matithemati/chocpilot/app/chocpilot/assets/chocpilot.png

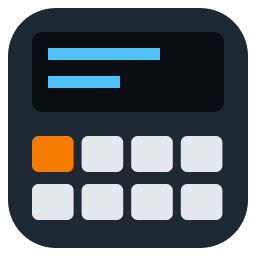
app/chocpilot/assets/chocpilot.png
