matithemati/chocpilot/docs/img/case_exploded.png

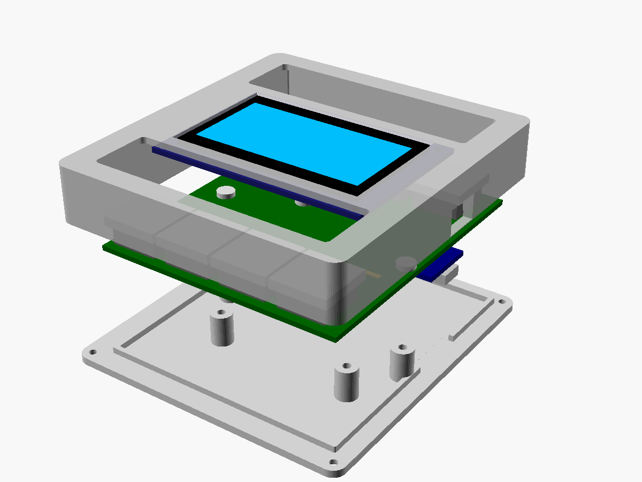
docs/img/case_exploded.png
