matithemati/chocpilot/docs/img/oled_242_shengyang.png

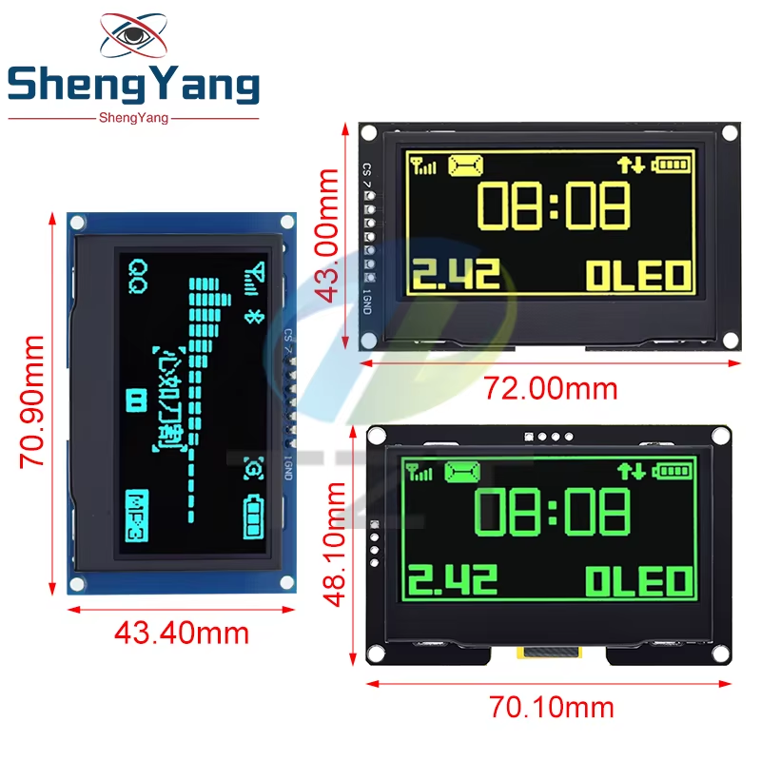
docs/img/oled_242_shengyang.png
