matithemati/chocpilot/docs/img/pcb_compact.png

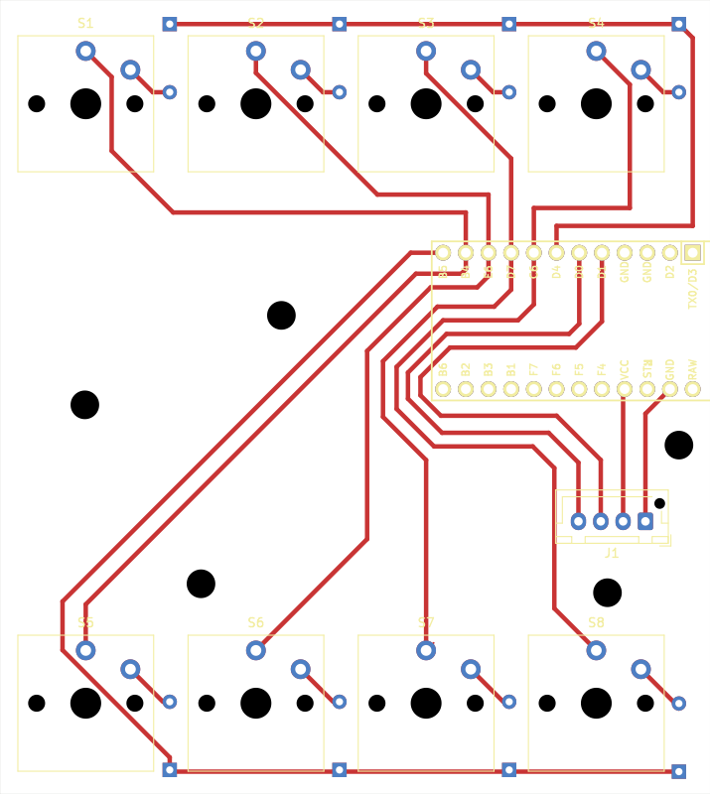
docs/img/pcb_compact.png
