matithemati/chocpilot/docs/schematic.png

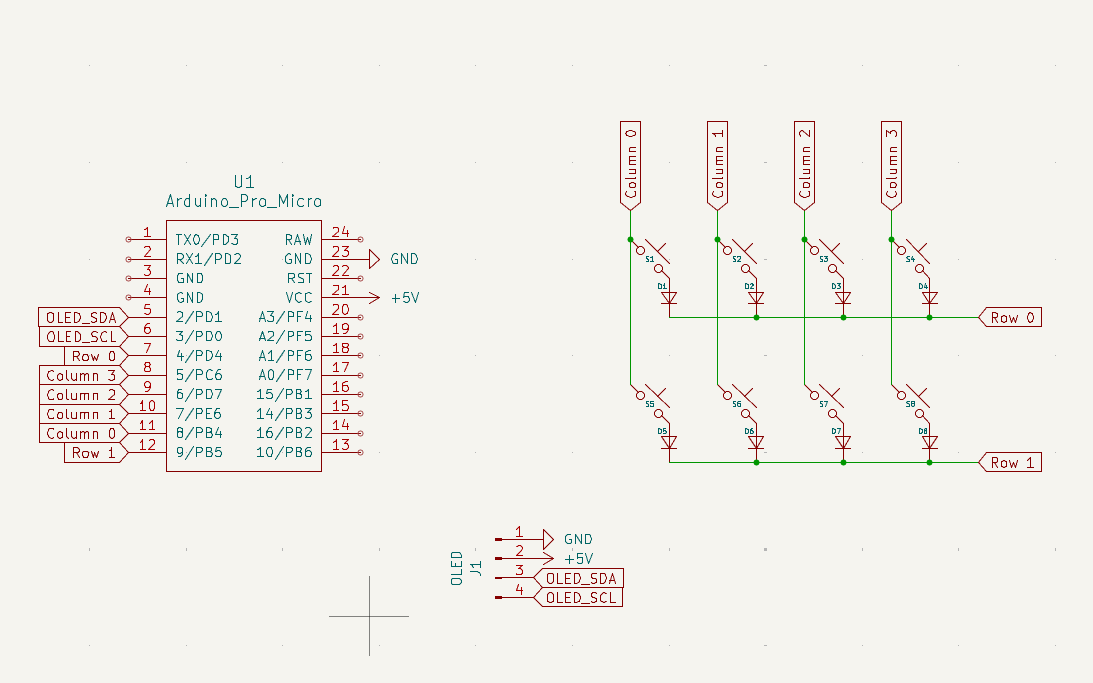
docs/schematic.png
