matithemati/chocpilot/pcb/chocpilot-v2/img/pcb_bottom.png

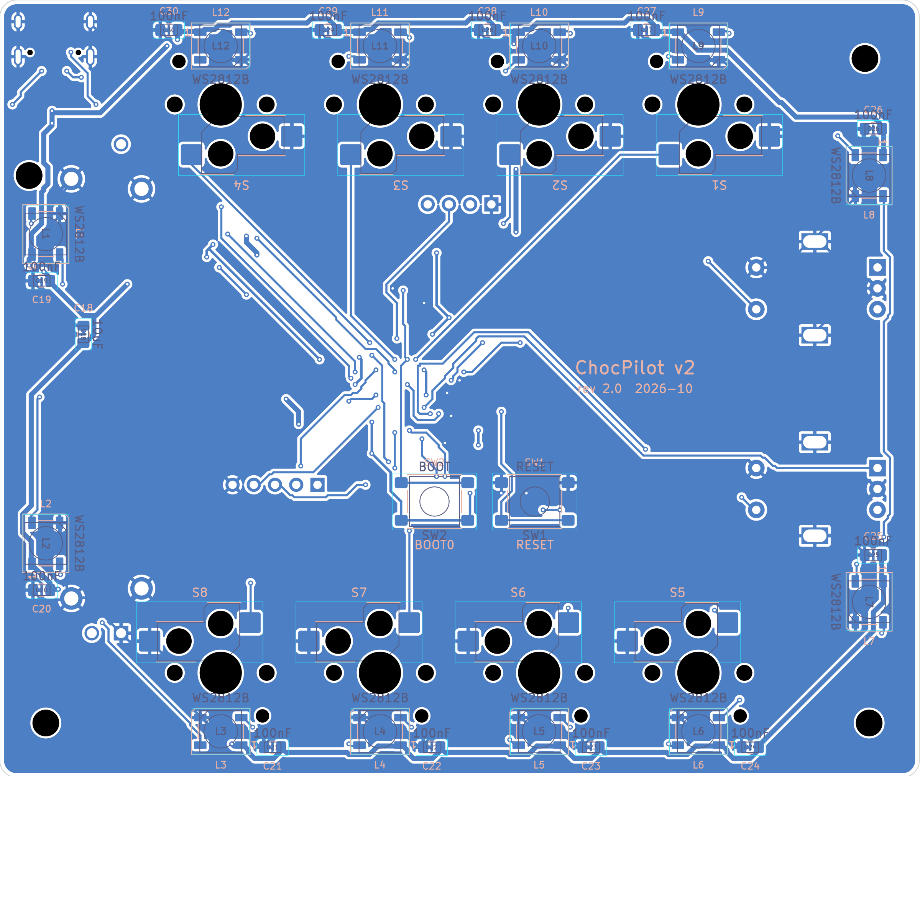
pcb/chocpilot-v2/img/pcb_bottom.png
