matithemati/chocpilot/pcb/chocpilot-v2/img/pcb_top.png

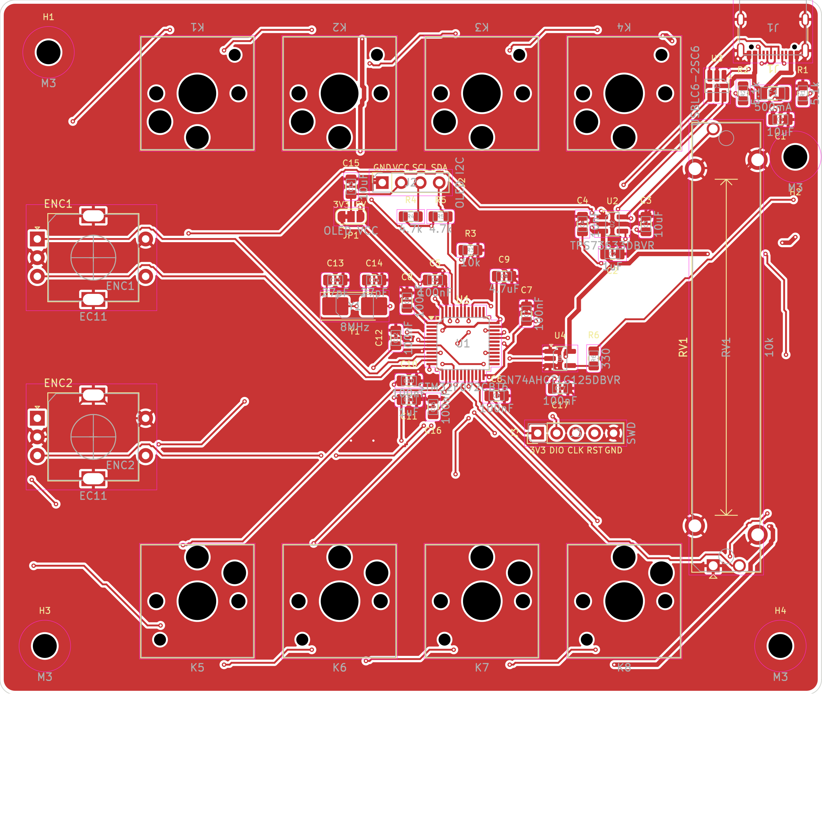
pcb/chocpilot-v2/img/pcb_top.png
