matithemati/chocpilot/pcb/chocpilot-v2/img/render_bottom.png

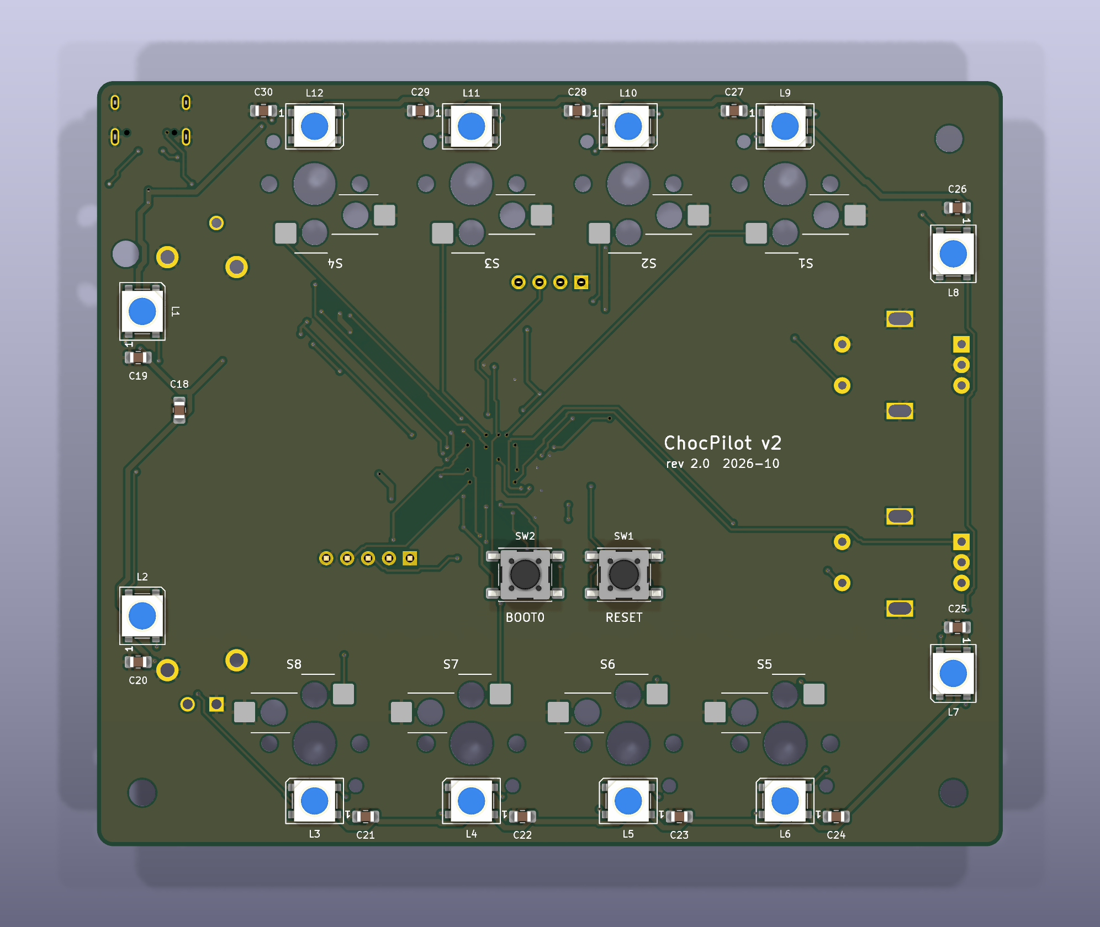
pcb/chocpilot-v2/img/render_bottom.png
