matithemati/chocpilot/pcb/chocpilot-v2/img/schematic.png

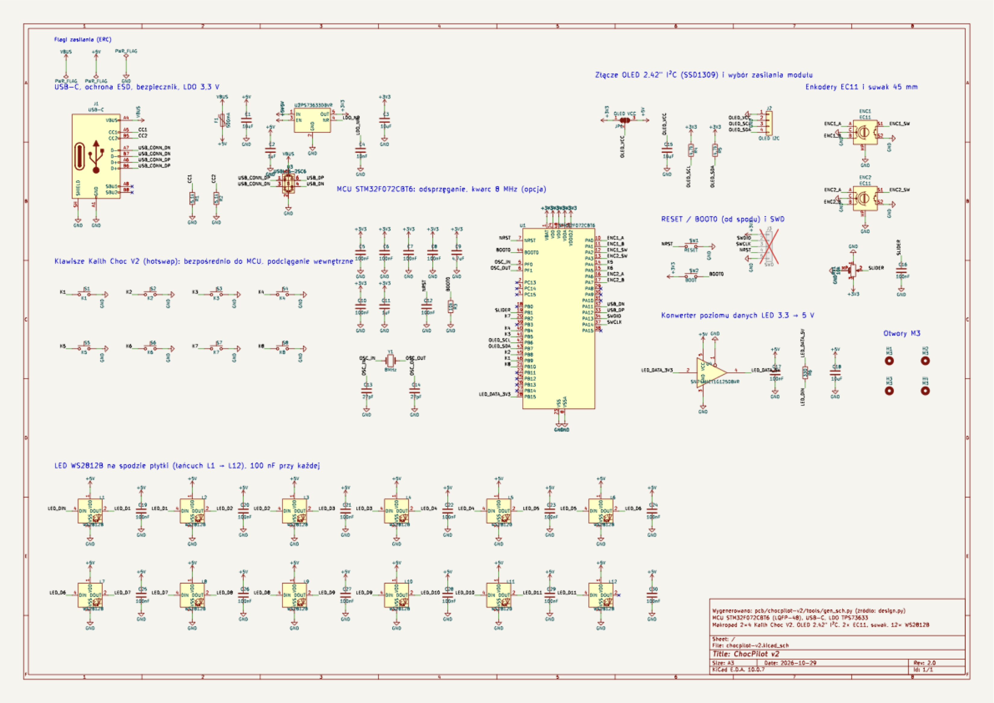
pcb/chocpilot-v2/img/schematic.png
