matithemati/chocpilot/docs/img/case_assembly.png

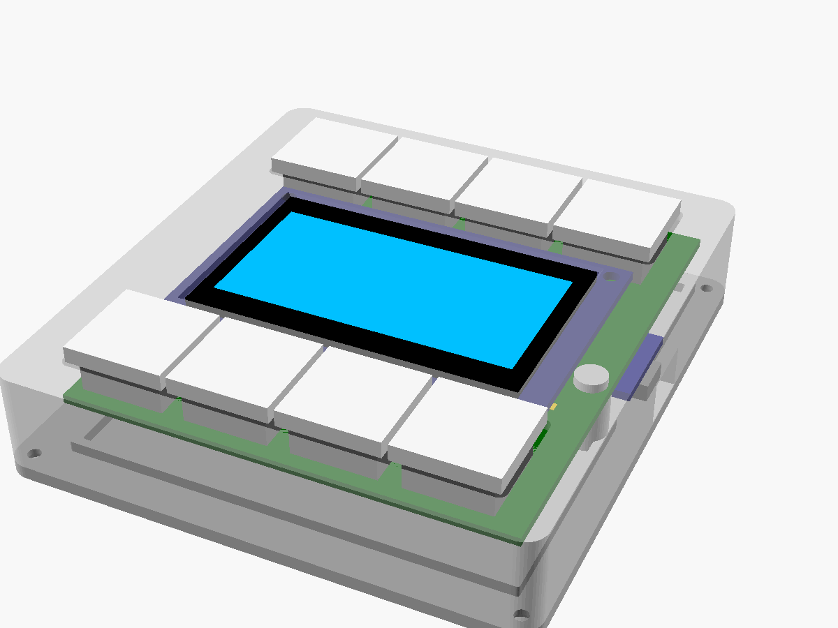
docs/img/case_assembly.png
