matithemati/chocpilot/pcb/chocpilot-v2/img/schematic.pdf

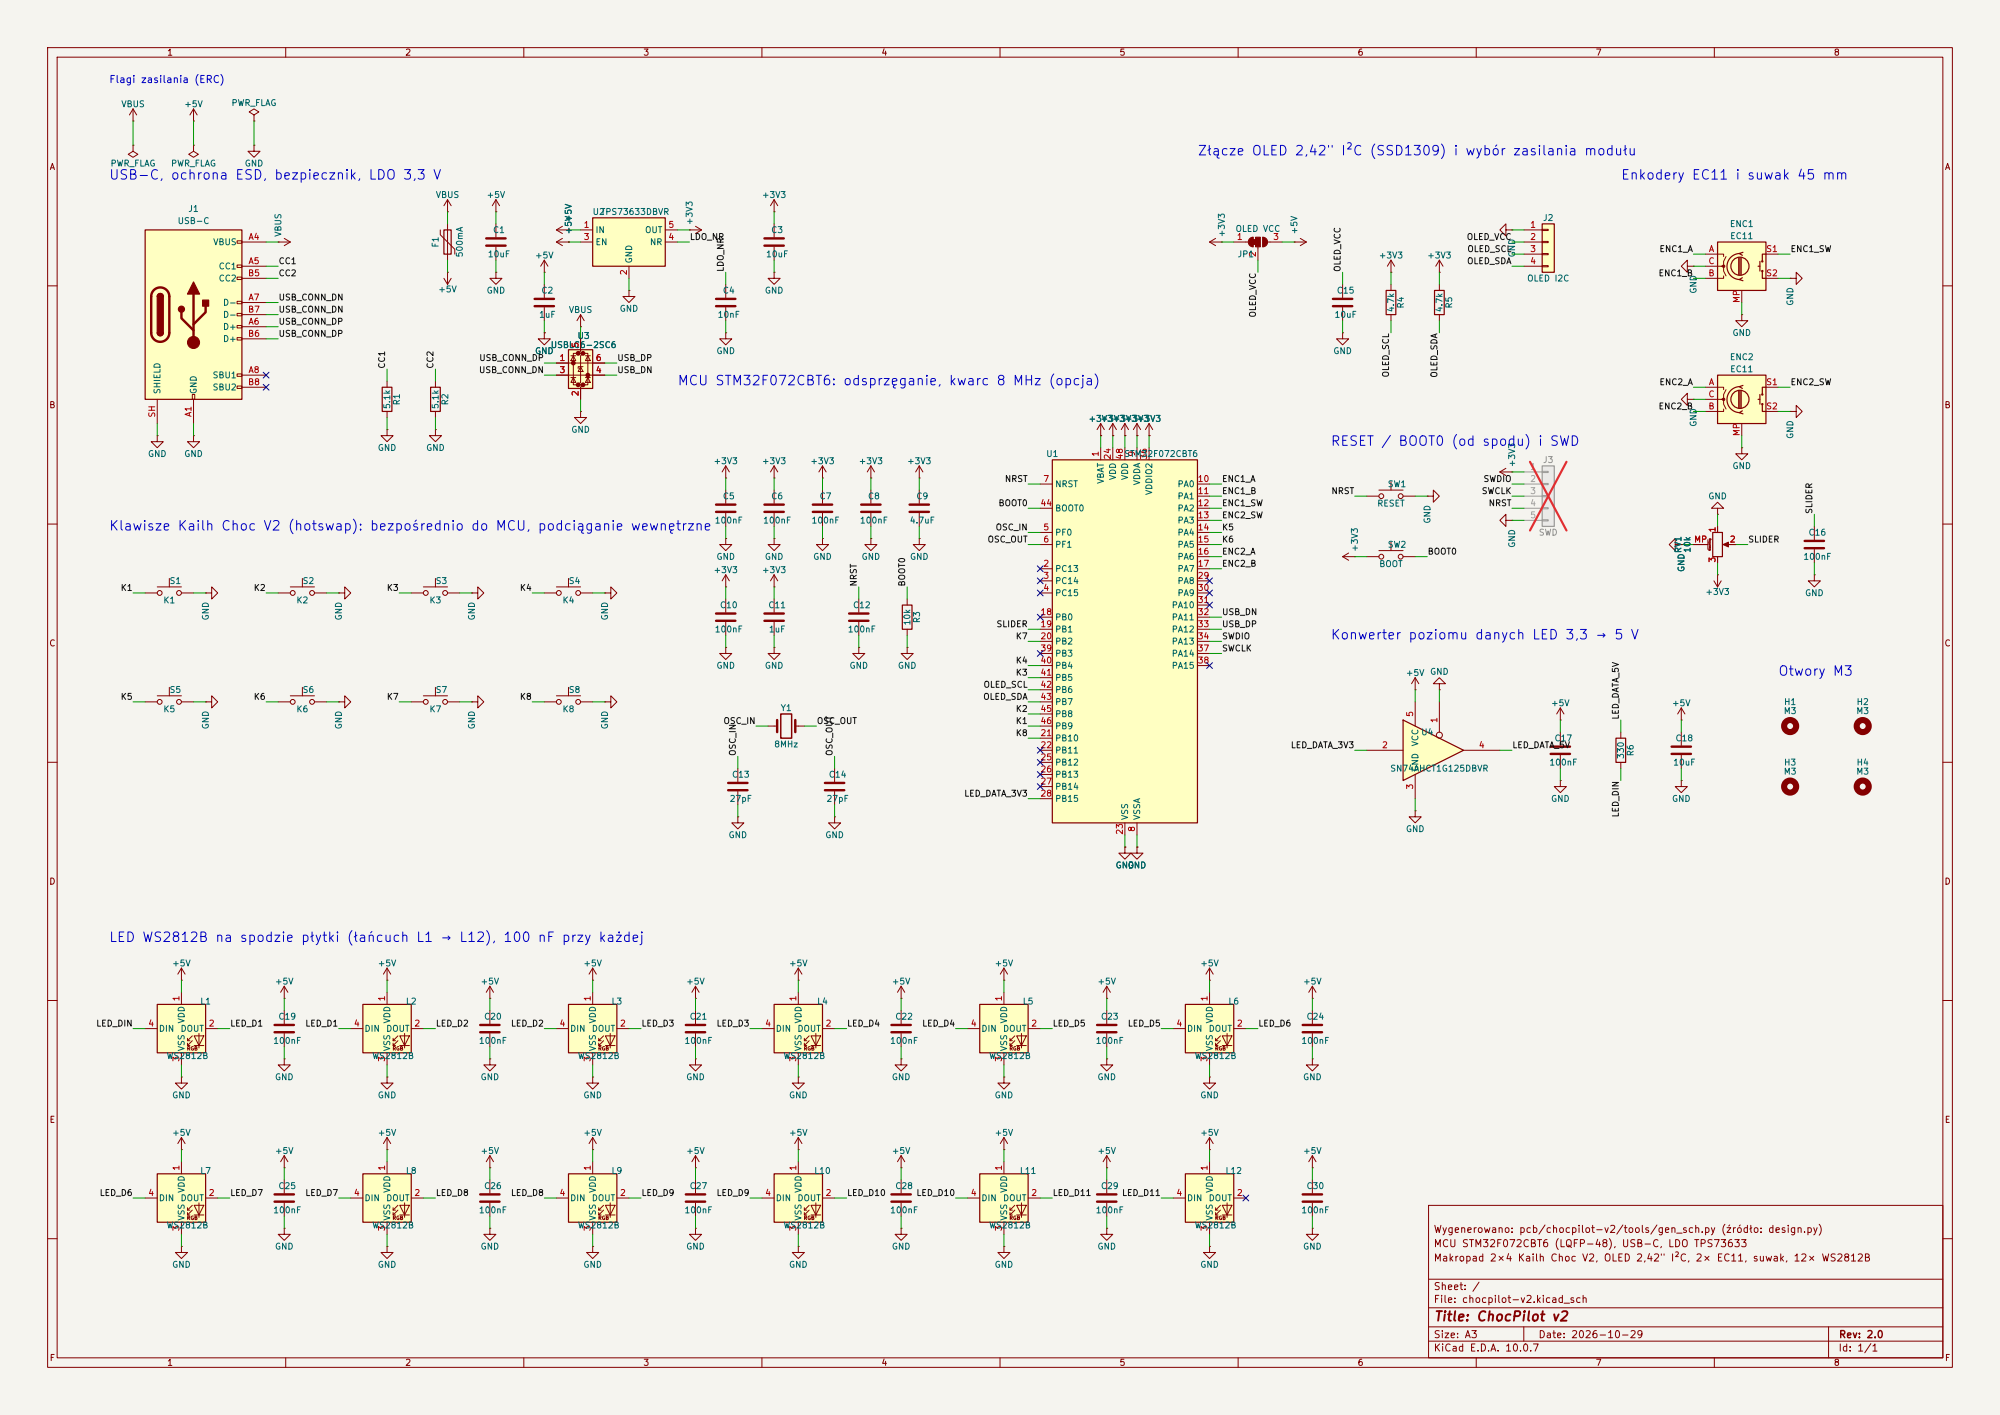
[picture p12: page 1]

Złącze OLED 2,42" I²C (SSD1309) i wybór zasilania modułu
LED_D6 OLED_VCC

USB-C, ochrona ESD, bezpiecznik, LDO 3,3 V

GND
MCU STM32F072CBT6: odsprzęganie, kwarc 8 MHz (opcja)

RESET / BOOT0 (od spodu) i SWD

Klawisze Kailh Choc V2 (hotswap): bezpośrednio do MCU, podciąganie wewnętrzne

Konwerter poziomu danych LED 3,3 → 5 V

LED WS2812B na spodzie płytki (łańcuch L1 → L12), 100 nF przy każdej

Wygenerowano: pcb/chocpilot-v2/tools/gen_sch.py (źródło: design.py) C27
LED_D9

MCU STM32F072CBT6 (LQFP-48), USB-C, LDO TPS73633
Makropad 2×4 Kailh Choc V2, OLED 2,42" I²C, 2× EC11, suwak, 12× WS2812B

Size: A3 | Rev: 2.0 | F Date: 2026-10-29
KiCad E.D.A. 10.0.7 | Id: 1/1
