matithemati/chocpilot/pcb/chocpilot-v2/chocpilot-v2.kicad_pcb

## KiCad design pcb/chocpilot-v2/chocpilot-v2.kicad_pcb (2026-10-29)

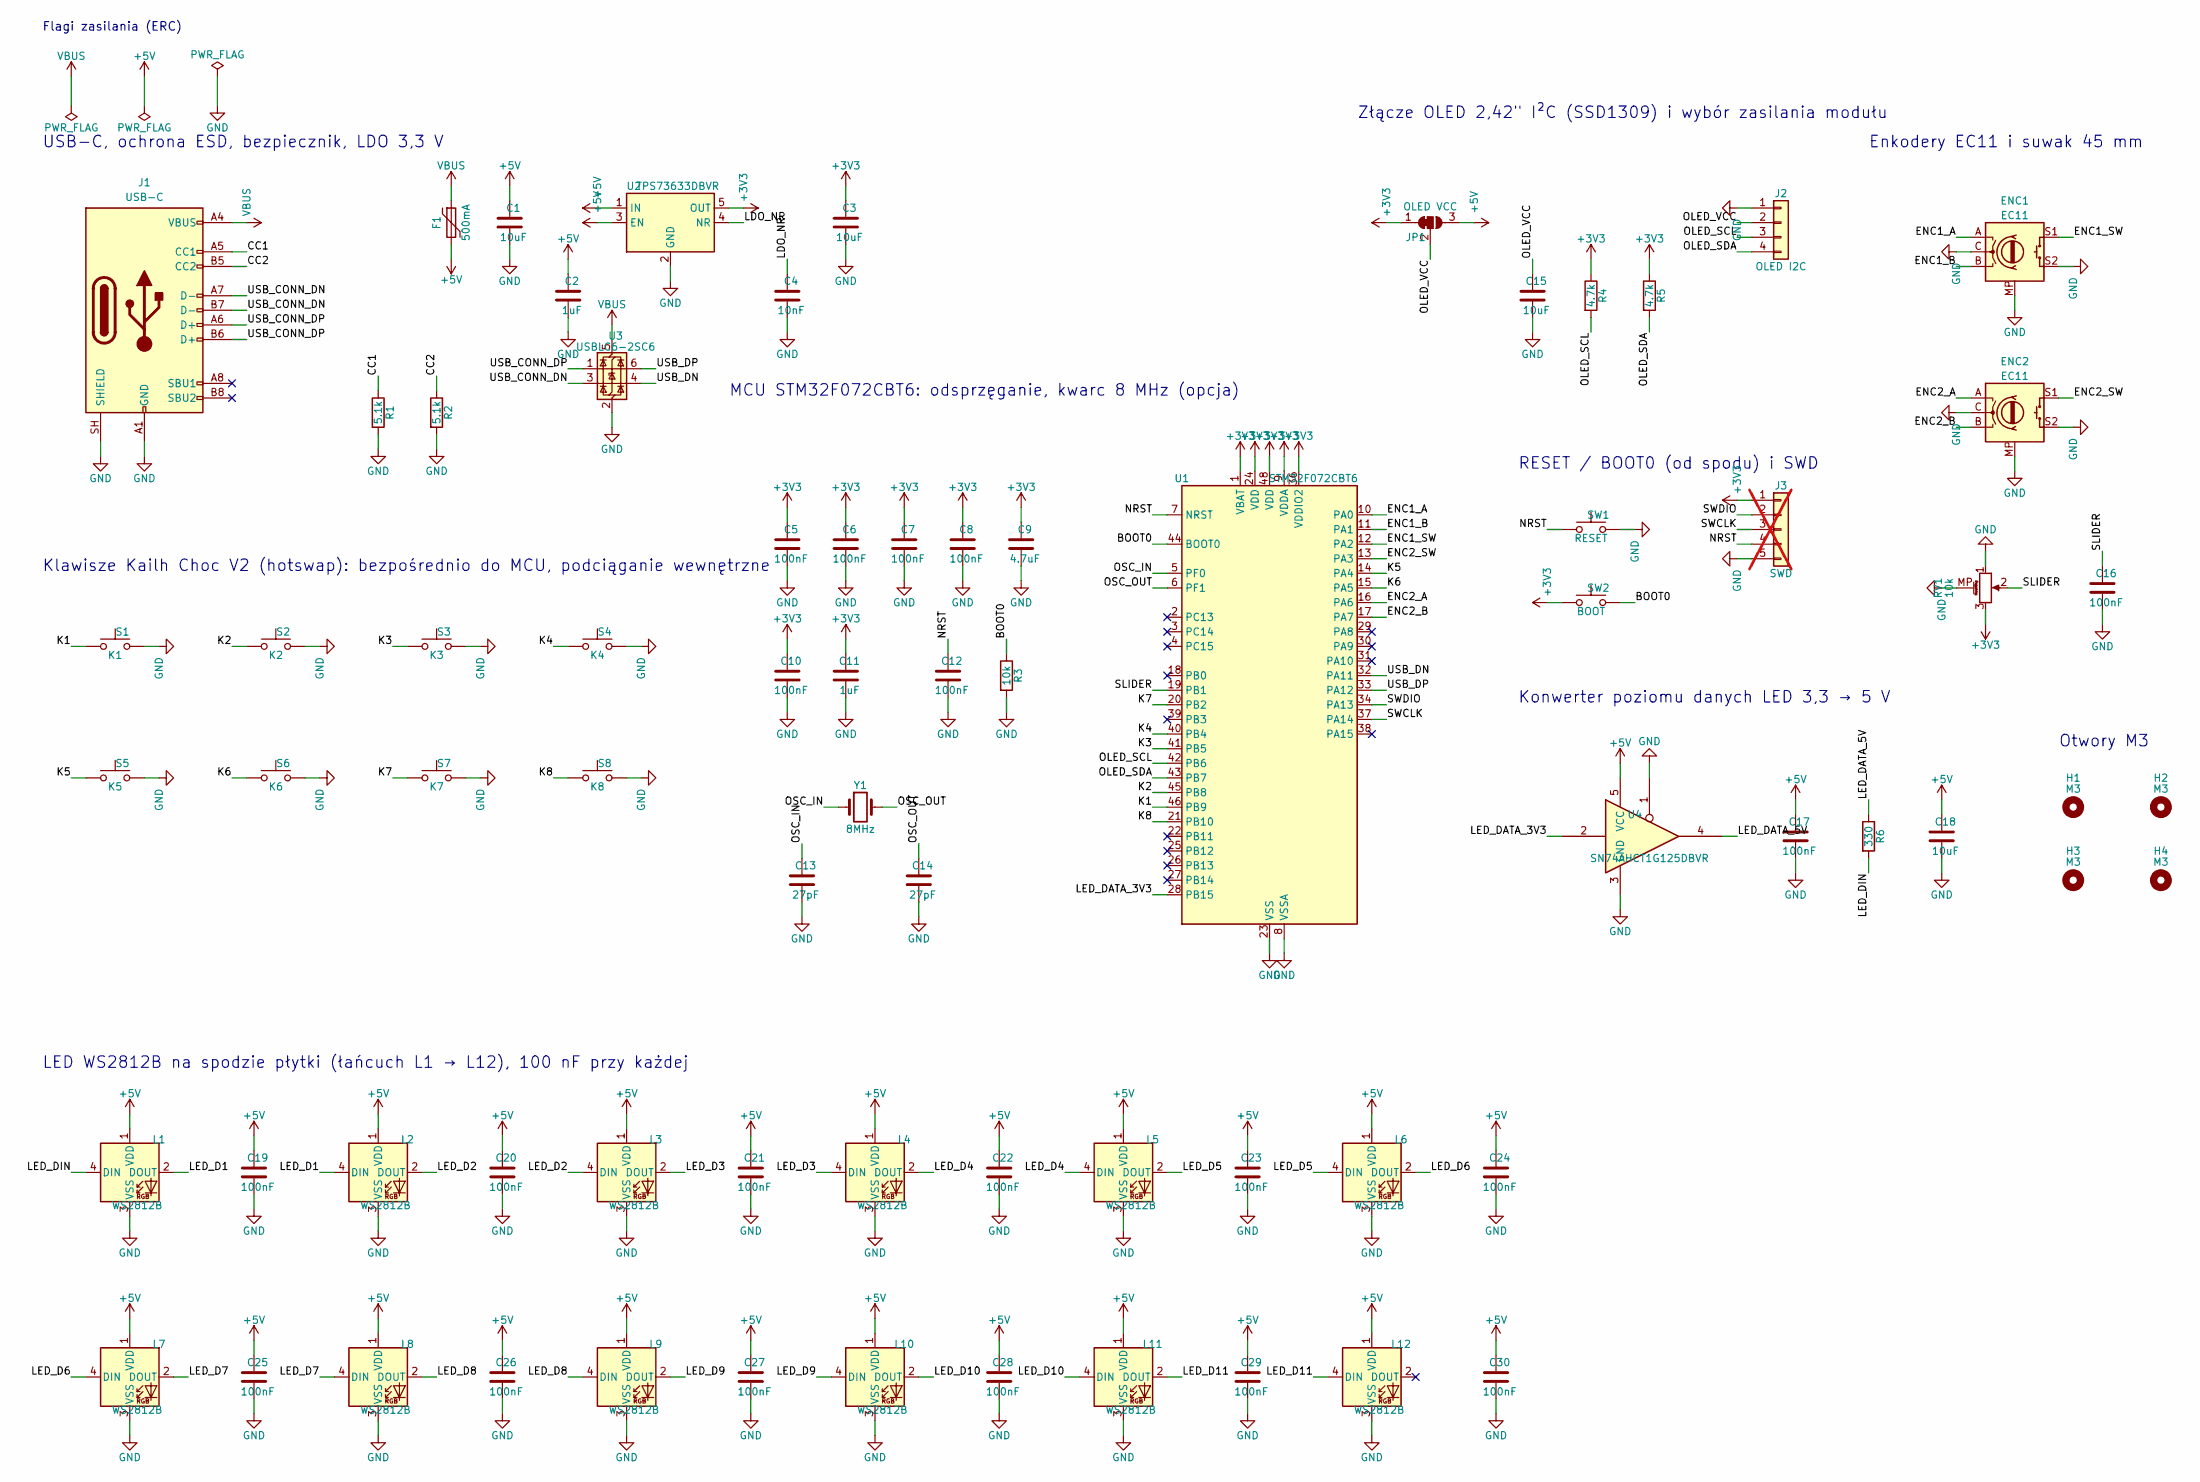
[picture p13: schematic chocpilot-v2.kicad_sch, ChocPilot v2]

Parts:
C1, C3, C15, C18: 10uF; C_0805_2012Metric_Pad1.18x1.45mm_HandSolder; MPN CL21A106KAYNNNE
C2, C11: 1uF; C_0805_2012Metric_Pad1.18x1.45mm_HandSolder; MPN CL21B105KBFNNNE
C4: 10nF; C_0805_2012Metric_Pad1.18x1.45mm_HandSolder; MPN CL21B103KBANNNC
C5, C6, C7, C8, C10, C12, C16, C17, C19, C20, C21, C22, C23, C24, C25, C26, C27, C28, C29, C30: 100nF; C_0805_2012Metric_Pad1.18x1.45mm_HandSolder; MPN CL21B104KBCNNNC
C9: 4.7uF; C_0805_2012Metric_Pad1.18x1.45mm_HandSolder; MPN CL21A475KAQNNNE
C13, C14: 27pF; C_0805_2012Metric_Pad1.18x1.45mm_HandSolder; MPN CL21C270JBANNNC
ENC1, ENC2: EC11; RotaryEncoder_Alps_EC11E-Switch_Vertical_H20mm; MPN EC11E15244G1
F1: 500mA; Fuse_1206_3216Metric_Pad1.42x1.75mm_HandSolder; MPN MF-NSMF050-2
H1, H2, H3, H4: M3; MountingHole_3.2mm_M3
J1: USB-C; USB_C_Receptacle_GCT_USB4105-xx-A_16P_TopMnt_Horizontal; MPN USB4105-GF-A
J2: OLED I2C; PinSocket_1x04_P2.54mm_Vertical; MPN DS1023-1*4S21
J3: SWD; PinHeader_1x05_P2.54mm_Vertical; MPN DS1021-1*5SF11-B; not fitted
JP1: OLED VCC; SolderJumper-3_P1.3mm_Bridged12_RoundedPad1.0x1.5mm
L1, L2, L3, L4, L5, L6, L7, L8, L9, L10, L11, L12: WS2812B; LED_WS2812B_PLCC4_5.0x5.0mm_P3.2mm; MPN WS2812B-V5
R1, R2: 5.1k; R_0805_2012Metric_Pad1.20x1.40mm_HandSolder; MPN RC0805FR-075K1L
R3: 10k; R_0805_2012Metric_Pad1.20x1.40mm_HandSolder; MPN RC0805FR-0710KL
R4, R5: 4.7k; R_0805_2012Metric_Pad1.20x1.40mm_HandSolder; MPN RC0805FR-074K7L
R6: 330; R_0805_2012Metric_Pad1.20x1.40mm_HandSolder; MPN RC0805FR-07330RL
RV1: 10k; Potentiometer_Bourns_PTA4543_Single_Slide; MPN PTA4543-2015DPA103
S1: K1; SW_Kailh_Choc_V1V2_Hotswap_1u; MPN CPG135001S30 (gniazdo) + CPG1353 (Choc 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
S2: K2; SW_Kailh_Choc_V1V2_Hotswap_1u; MPN CPG135001S30 (gniazdo) + CPG1353 (Choc 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
S3: K3; SW_Kailh_Choc_V1V2_Hotswap_1u; MPN CPG135001S30 (gniazdo) + CPG1353 (Choc 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
S4: K4; SW_Kailh_Choc_V1V2_Hotswap_1u; MPN CPG135001S30 (gniazdo) + CPG1353 (Choc 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
S5: K5; SW_Kailh_Choc_V1V2_Hotswap_1u; MPN CPG135001S30 (gniazdo) + CPG1353 (Choc 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
S6: K6; SW_Kailh_Choc_V1V2_Hotswap_1u; MPN CPG135001S30 (gniazdo) + CPG1353 (Choc 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
S7: K7; SW_Kailh_Choc_V1V2_Hotswap_1u; MPN CPG135001S30 (gniazdo) + CPG1353 (Choc 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
S8: K8; SW_Kailh_Choc_V1V2_Hotswap_1u; MPN CPG135001S30 (gniazdo) + CPG1353 (Choc 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
SW1: RESET; SW_SPST_PTS645Sx43SMTR92; MPN PTS645SM43SMTR92 LFS
SW2: BOOT; SW_SPST_PTS645Sx43SMTR92; MPN PTS645SM43SMTR92 LFS
U1: STM32F072CBT6; LQFP-48_7x7mm_P0.5mm; MPN STM32F072CBT6
U2: TPS73633DBVR; SOT-23-5_HandSoldering; MPN TPS73633DBVR
U3: USBLC6-2SC6; SOT-23-6_Handsoldering; MPN USBLC6-2SC6
U4: SN74AHCT1G125DBVR; SOT-23-5_HandSoldering; MPN SN74AHCT1G125DBVR
Y1: 8MHz; Crystal_SMD_5032-2Pin_5.0x3.2mm_HandSoldering; MPN ABM3-8.000MHZ-D2Y-T

Connections:
+3V3: C3.1, C5.1, C6.1, C7.1, C8.1, C9.1, C10.1, C11.1, J3.1, JP1.1 (A), R4.1, R5.1, RV1.3, SW2.1, U1.1 (VBAT), U1.9 (VDDA), U1.24 (VDD), U1.36 (VDDIO2), U1.48 (VDD), U2.5 (OUT)
+5V: C1.1, C2.1, C17.1, C18.1, C19.1, C20.1, C21.1, C22.1, C23.1, C24.1, C25.1, C26.1, C27.1, C28.1, C29.1, C30.1, F1.2, JP1.3 (B), L1.1 (VDD), L2.1 (VDD), L3.1 (VDD), L4.1 (VDD), L5.1 (VDD), L6.1 (VDD), L7.1 (VDD), L8.1 (VDD), L9.1 (VDD), L10.1 (VDD), L11.1 (VDD), L12.1 (VDD), U2.1 (IN), U2.3 (EN), U4.5 (VCC)
/BOOT0: R3.1, SW2.2, U1.44 (BOOT0)
/CC1: J1.A5 (CC1), R1.1
/CC2: J1.B5 (CC2), R2.1
/ENC1_A: ENC1.A, U1.10 (PA0)
/ENC1_B: ENC1.B, U1.11 (PA1)
/ENC1_SW: ENC1.S1, U1.12 (PA2)
/ENC2_A: ENC2.A, U1.16 (PA6)
/ENC2_B: ENC2.B, U1.17 (PA7)
/ENC2_SW: ENC2.S1, U1.13 (PA3)
/K1: S1.1, U1.46 (PB9)
/K2: S2.1, U1.45 (PB8)
/K3: S3.1, U1.41 (PB5)
/K4: S4.1, U1.40 (PB4)
/K5: S5.1, U1.14 (PA4)
/K6: S6.1, U1.15 (PA5)
/K7: S7.1, U1.20 (PB2)
/K8: S8.1, U1.21 (PB10)
/LDO_NR: C4.1, U2.4 (NR)
/LED_D1: L1.2 (DOUT), L2.4 (DIN)
/LED_D2: L2.2 (DOUT), L3.4 (DIN)
/LED_D3: L3.2 (DOUT), L4.4 (DIN)
/LED_D4: L4.2 (DOUT), L5.4 (DIN)
/LED_D5: L5.2 (DOUT), L6.4 (DIN)
/LED_D6: L6.2 (DOUT), L7.4 (DIN)
/LED_D7: L7.2 (DOUT), L8.4 (DIN)
/LED_D8: L8.2 (DOUT), L9.4 (DIN)
/LED_D9: L9.2 (DOUT), L10.4 (DIN)
/LED_D10: L10.2 (DOUT), L11.4 (DIN)
/LED_D11: L11.2 (DOUT), L12.4 (DIN)
/LED_DATA_3V3: U1.28 (PB15), U4.2
/LED_DATA_5V: R6.1, U4.4
/LED_DIN: L1.4 (DIN), R6.2
/NRST: C12.1, J3.4, SW1.1, U1.7 (NRST)
/OLED_SCL: J2.3, R4.2, U1.42 (PB6)
/OLED_SDA: J2.4, R5.2, U1.43 (PB7)
/OLED_VCC: C15.1, J2.2, JP1.2 (C)
/OSC_IN: C13.1, U1.5 (PF0), Y1.1
/OSC_OUT: C14.1, U1.6 (PF1), Y1.2
/SLIDER: C16.1, RV1.2, U1.19 (PB1)
/SWCLK: J3.3, U1.37 (PA14)
/SWDIO: J3.2, U1.34 (PA13)
/USB_CONN_DN: J1.A7 (D-), J1.B7 (D-), U3.3 (I/O2)
/USB_CONN_DP: J1.A6 (D+), J1.B6 (D+), U3.1 (I/O1)
/USB_DN: U1.32 (PA11), U3.4 (I/O2)
/USB_DP: U1.33 (PA12), U3.6 (I/O1)
GND: C1.2, C2.2, C3.2, C4.2, C5.2, C6.2, C7.2, C8.2, C9.2, C10.2, C11.2, C12.2, C13.2, C14.2, C15.2, C16.2, C17.2, C18.2, C19.2, C20.2, C21.2, C22.2, C23.2, C24.2, C25.2, C26.2, C27.2, C28.2, C29.2, C30.2, ENC1.C, ENC1.MP, ENC1.S2, ENC2.C, ENC2.MP, ENC2.S2, J1.A1 (GND), J1.A12 (GND), J1.B1 (GND), J1.B12 (GND), J1.SH (SHIELD), J2.1, J3.5, L1.3 (VSS), L2.3 (VSS), L3.3 (VSS), L4.3 (VSS), L5.3 (VSS), L6.3 (VSS), L7.3 (VSS), L8.3 (VSS), L9.3 (VSS), L10.3 (VSS), L11.3 (VSS), L12.3 (VSS), R1.2, R2.2, R3.2, RV1.1, RV1.MP (MountPin), S1.2, S2.2, S3.2, S4.2, S5.2, S6.2, S7.2, S8.2, SW1.2, U1.8 (VSSA), U1.23 (VSS), U1.35 (VSS), U1.47 (VSS), U2.2 (GND), U3.2 (GND), U4.1, U4.3 (GND)
VBUS: F1.1, J1.A4 (VBUS), J1.A9 (VBUS), J1.B4 (VBUS), J1.B9 (VBUS), U3.5 (VBUS)

Notes on the sheet:
USB-C, ochrona ESD, bezpiecznik, LDO 3,3 V
MCU STM32F072CBT6: odsprzęganie, kwarc 8 MHz (opcja)
Złącze OLED 2,42" I²C (SSD1309) i wybór zasilania modułu
Enkodery EC11 i suwak 45 mm
Klawisze Kailh Choc V2 (hotswap): bezpośrednio do MCU, podciąganie wewnętrzne
RESET / BOOT0 (od spodu) i SWD
Konwerter poziomu danych LED 3,3 → 5 V
LED WS2812B na spodzie płytki (łańcuch L1 → L12), 100 nF przy każdej
Otwory M3
Flagi zasilania (ERC)

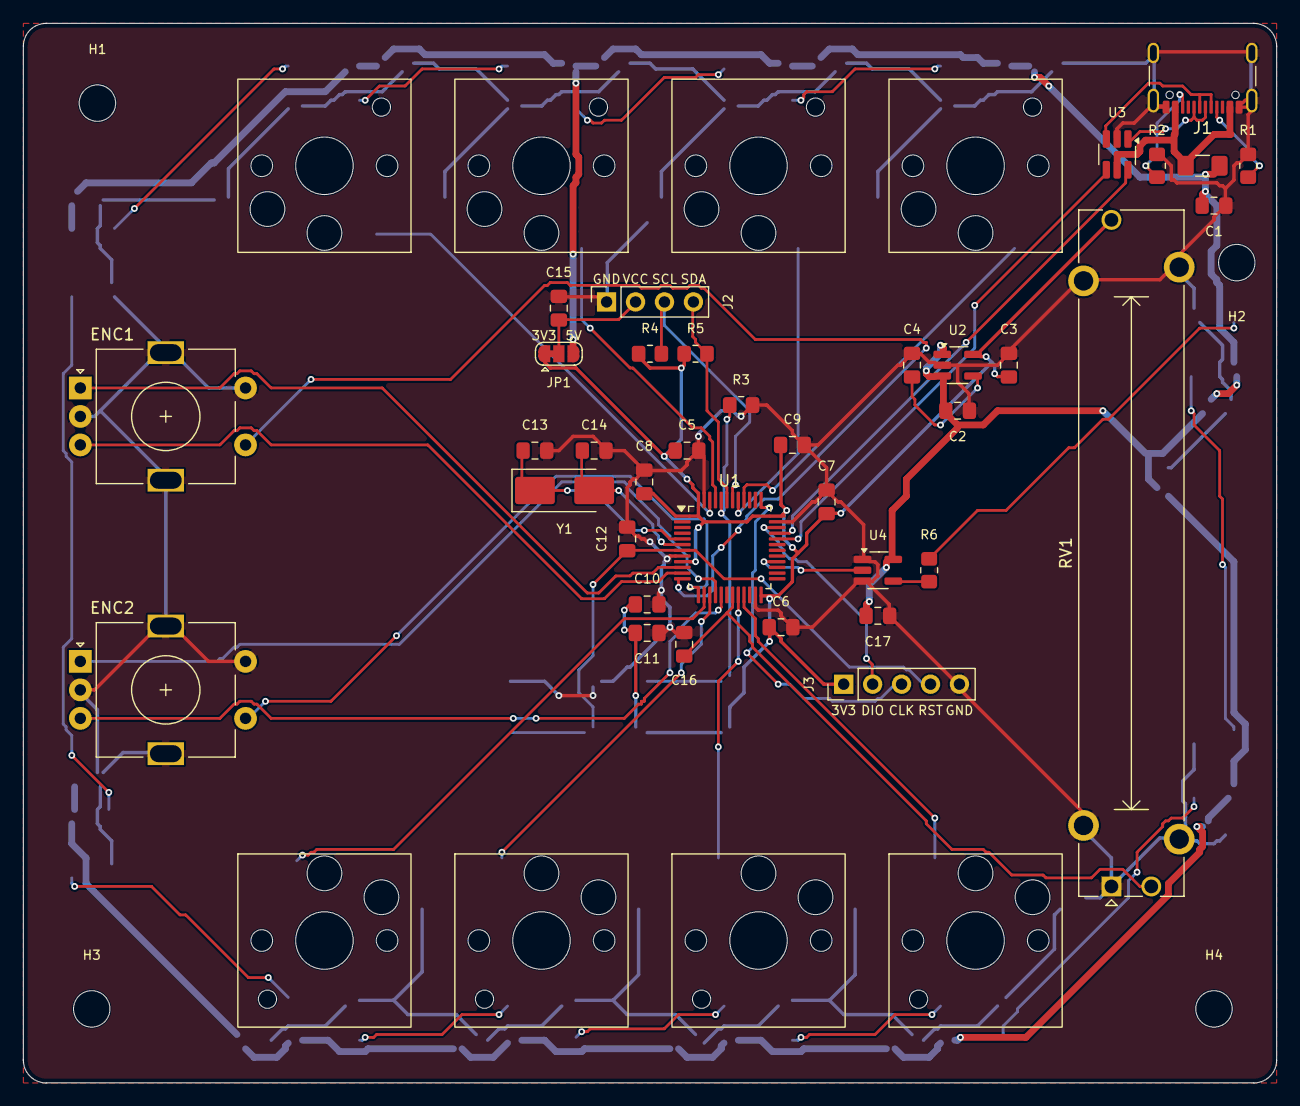
[picture p14: board chocpilot-v2.kicad_pcb from above]

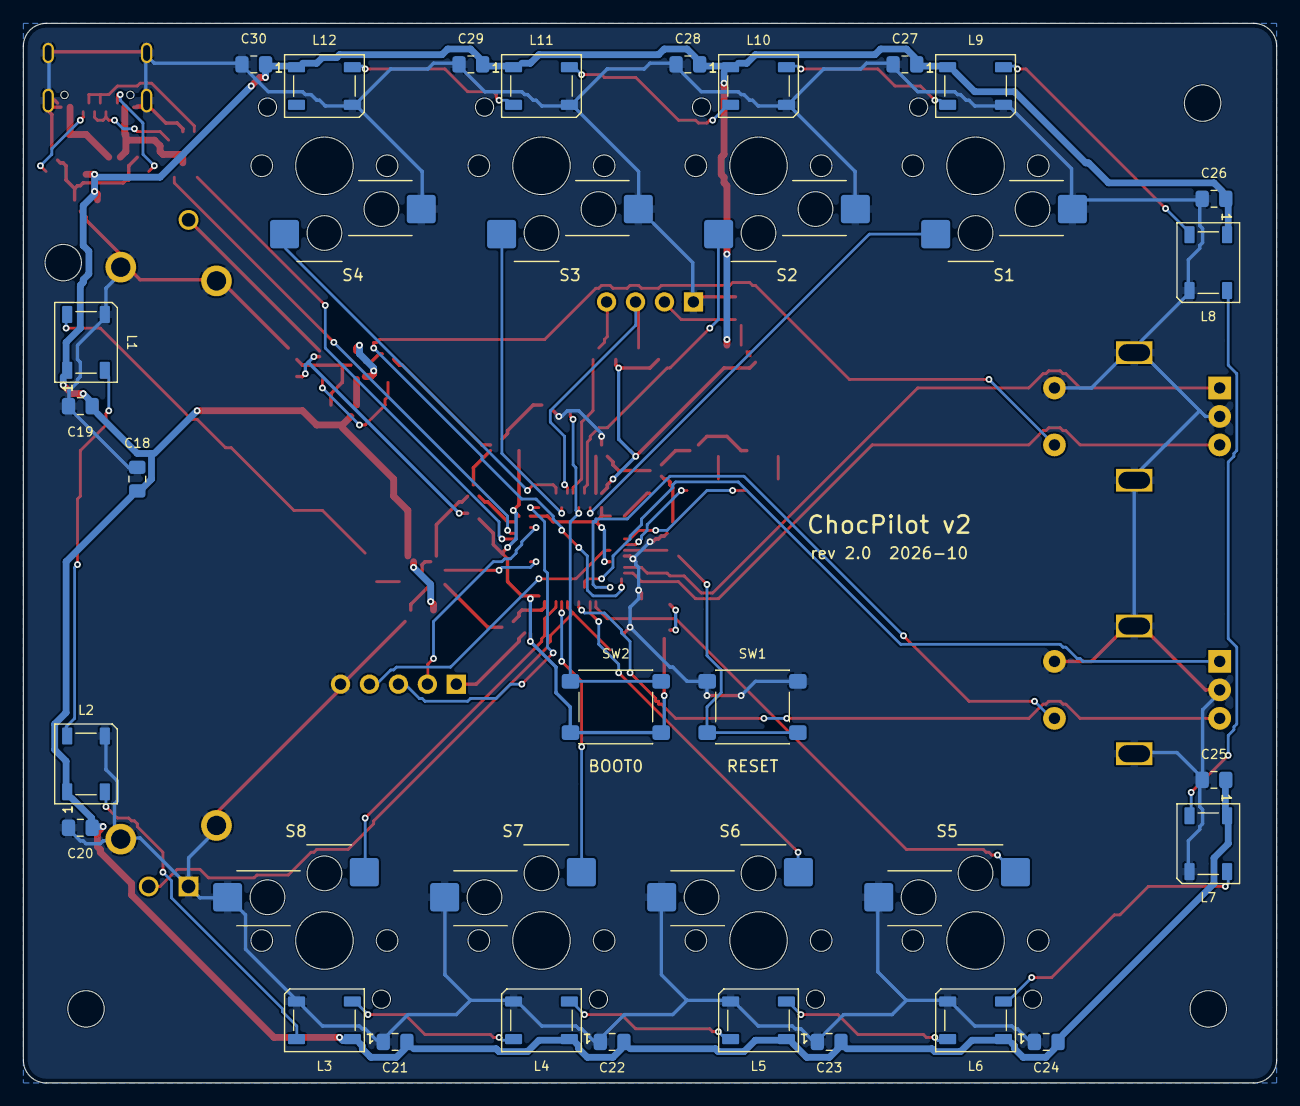
[picture p15: board chocpilot-v2.kicad_pcb from below]

Board: 2 copper layers, 110.0 x 93.0 mm, 75 parts (27 on the bottom side), 49 nets.
