matithemati/chocpilot/(commit log)

2026-10-26 ChocPilot: kopia projektu Tap32 (gałąź feature/pro-micro) ze zmienioną nazwą
    Punkt wyjścia: firmware z obsługą Pro Micro, aplikacja i dokumentacja Tap32,
    nazwy Tap32/tap32/TAP32 zamienione na ChocPilot/chocpilot/CHOCPILOT.
    Bez starych obudów OpenSCAD (były dla matrycy 3×3 MX i enkodera EC11).
    Schemat płytki ChocPilot: docs/schematic.png.
2026-10-26 Firmware ChocPilot: Pro Micro, matryca 2×4 Choc, OLED 2,42" SSD1309
    - tylko Arduino Pro Micro (promicro / promicro_3v3); usunięte płytki KB2040 i XIAO,
    enkoder (ChocPilot nie ma pokrętła) i kodek ArduinoJson,
    - mapa pinów wg schematu: Row 0/1 = D4/D9, Column 0–3 = D8/D7/D6/D5,
    - 8 klawiszy (protokół: keys 8, encoder false), etykiety do 10 znaków,
    - ekran SSD1309 128×64 na sprzętowym TWI (własny sterownik rejestrów, bez Wire);
    przy zamienionych SDA/SCL programowe I²C; nowe układy ekranów 128×64,
    - tryb testu: K1+K4 przez 3 s.
    Flash 25 856 / 28 672 B, RAM statycznie 1 958 / 2 560 B.
2026-10-26 Aplikacja ChocPilot: 8 klawiszy 2×4, bez pokrętła, podgląd OLED 128×64
    - rdzeń: KEY_COUNT 8 (KEY_ROWS × KEY_COLS), etykiety do 10 znaków, bez zdarzeń enc,
    gestów obrotu, ustawień pokrętła i slotów enc_cw/enc_ccw,
    - nowe profile domyślne (dolny rząd: głośność, play, wycisz; przytrzymanie K5/K8
    zmienia profil) i domyślny tryb awaryjny zgodny z firmware,
    - GUI: podgląd urządzenia 2×4 bez pokrętła, bez edytora pokrętła i jego ustawień,
    podgląd OLED rysowany tym samym krojem 5×7 i układem co firmware, nowe logo,
    - wykrywanie portu tylko po nazwie ChocPilot i VID:PID Pro Micro,
    - firmware: wąski wariant kroju – 6 znaków w wierszu komórki siatki.
    Co-Autho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
2026-10-26 Dokumentacja ChocPilot: README, WIRING (schemat 2×4, J1, Pro Micro), PROTOCOL
2026-10-26 Obudowa OpenSCAD: klawisze – ekran 2,42" – klawisze
    Skorupa z dwoma niskimi pokładami na rzędy Choc i podwyższonym, fazowanym pokładem z oknem
    OLED i słupkami do przykręcenia modułu; dno ze słupkami pod PCB, kołnierzem i wpustami na
    nóżki; wycięcie USB w prawej ściance. Wymiary płytki z rozmieszczenia kbplacer (plik PCB
    nie był zapisany) – parametry do potwierdzenia.
    [chocpilot_case.scad]
2026-10-26 Skrypt flash.ps1 i obudowa dopasowana do zapisanego PCB
    - firmware/flash.ps1: znajduje/instaluje PlatformIO, pilnuje, by aplikacja nie trzymała
    portu, kompiluje i wgrywa (-Board 3v3, -Port, -BuildOnly, -CloseApp),
    - obudowa z geometrii tap32.kicad_pcb: obrys 79,5 × 117 mm, 5 słupków M3 (H1–H5),
    otwory klawiszy wyśrodkowane na rzędach, kieszeń na Pro Micro wystające poza PCB,
    USB na osi gniazda, pokład ekranu podniesiony nad wtyk JST XH w J1 (j1_clear).
    [chocpilot_case.scad]
2026-10-26 OLED: moduł ShengYang 2,42" – warianty 4-pin I²C i 7-pin SPI w obudowie i dokumentacji
    - case: oled_variant (i2c_4pin 70,10 × 48,10 mm domyślnie, spi_7pin 72 × 43 mm), moduł
    odsuwany od J1, asercje: słupek–szkło i zmieszczenie modułu pod pokładem,
    - docs/WIRING.md i README: model, wymiary z karty sprzedawcy, wyprowadzenia, co zmierzyć,
    - docs/img/oled_242_shengyang.png: karta sprzedawcy.
    [chocpilot_case.scad]
2026-10-26 Docs: używany OLED to ShengYang 2,42" w wersji 4-pin I²C (70,10 × 48,10 mm)
2026-10-26 Kompaktowa płytka i obudowa z płaską górą: ekran równo z powierzchnią
    - obudowa 90,3 × 99,6 × 20 mm (było 90 × 128 × 30): płaska góra na wysokości klawiszy,
    szkło OLED w otworze 0,4 mm poniżej powierzchni, moduł wisi 2 mm nad PCB, przykręcony od
    spodu do płyty; druk górą w dół bez podpór; asercje: szkło nie wystaje, moduł z dala od
    przełączników, materiał płyty wokół wkrętów modułu,
    - geometria z nowego PCB: obrys 79,5 × 88,75 mm, rzędy 67 mm od siebie, ekran pośrodku,
    otwory H1–H5 pod modułem (wkręty ISO 7380), J1 jako pola na przewody,
    - docs: wymagania „płasko pod modułem”, przewody zamiast złącza XH, podgląd PCB.
    Co-Authored-B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
    [chocpilot_case.scad]
2026-10-26 Obudowa symetryczna w poziomie względem klawiszy i ekranu
    PCB jest szersza w prawo (Pro Micro), więc obrys obudowy liczony jest od środka rzędów:
    lewa ścianka 8,15 mm, prawa 5 mm; obudowa 93,45 × 99,55 × 20 mm.
    [chocpilot_case.scad]
2026-10-26 Obudowa symetryczna także w pionie względem klawiszy i ekranu
    Obrys liczony od środka klawiszy i ekranu w obu osiach: ścianki lewa 8,15 / prawa 5,
    dolna 6,45 / górna 5 mm; obudowa 93,45 × 101 × 20 mm.
    [chocpilot_case.scad]
2026-10-29 Płytka v2: STM32F072, USB-C, 2× EC11, suwak, 12× WS2812B (KiCad 10)
    Nowy projekt w pcb/chocpilot-v2: 8× Kailh Choc V2 w gniazdach hotswap,
    złącze OLED 2,42" I²C między rzędami, enkodery po lewej, suwak 45 mm po
    prawej, LED na spodzie. MCU STM32F072CBT6 (LQFP-48, USB bez kwarcu,
    DFU w ROM), LDO TPS73633, ESD USBLC6, bezpiecznik PTC.
    Schemat, płytka i BOM generowane z tools/design.py (własny router
    siatkowy). ERC 0/0, DRC z kontrolą zgodności ze schematem: 0 naruszeń,
    0 niepołączonych. BOM z numerami TME/Amazon, Gerbery, dokumentacja
    pinów, montażu i decyzji projektowych.
    [chocpilot-v2-B_Cu.gbl, chocpilot-v2-B_Mask.gbs, chocpilot-v2-B_Paste.gbp, chocpilot-v2-B_Silkscreen.gbo, chocpilot-v2-Edge_Cuts.gm1, chocpilot-v2-F_Cu.gtl, chocpilot-v2-F_Mask.gts, chocpilot-v2-F_Paste.gtp]
